vaovao1jp/pico_CW_TRX/Spurious.png

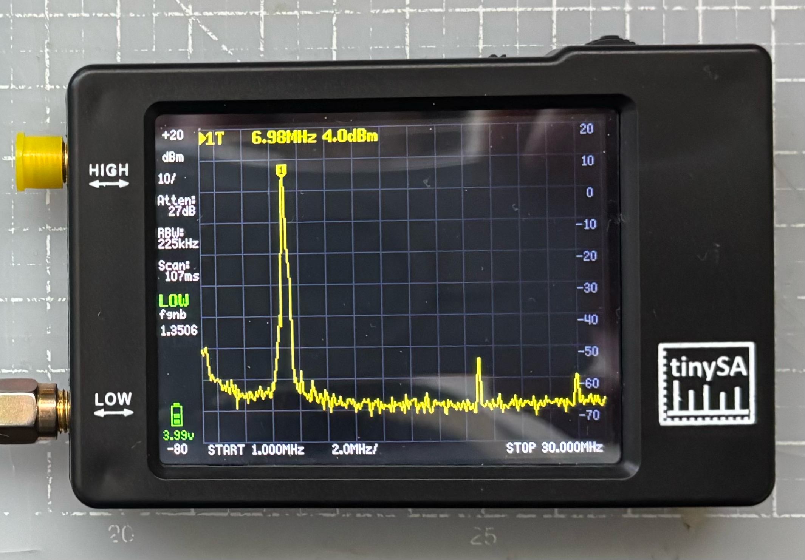
Spurious.png
