vaovao1jp/pico_CW_TRX/Logmag.png

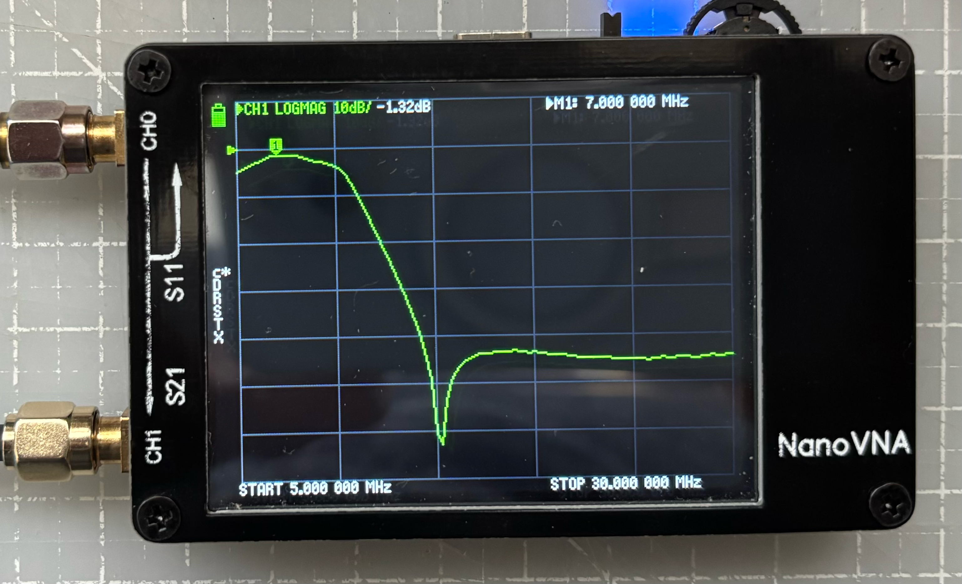
Logmag.png
