vaovao1jp/pico_CW_TRX/2026_4_17_OLED128x64.md

# I changed the OLED to 128x64 and added a waterfall.
I've uploaded a new version of the sketch.
### SDR_pico_CW_RTXv4_0E.ino

### To change the display on the band scope
Line 82 #define SCOPE_SENSITIVITY 15.0f    // Amplitude gain of the scope waveform (the higher the value, the higher the waveform rises)

Line 83 #define SCOPE_OFFSET      3.2f     // Raising the scope's noise floor (to detect invisible micro-noise)

### Waterfall display (signal strength)
Line 140 #define THRESHOLD 1  // Settings for Displaying Signal Strength

The circuit diagram is “pico_40mCW_TRX_microL.pdf”.

JR3XNW 2026/4/17
