vaovao1jp/pico_CW_TRX/pico_CW_TRX_26-07-15.pdf

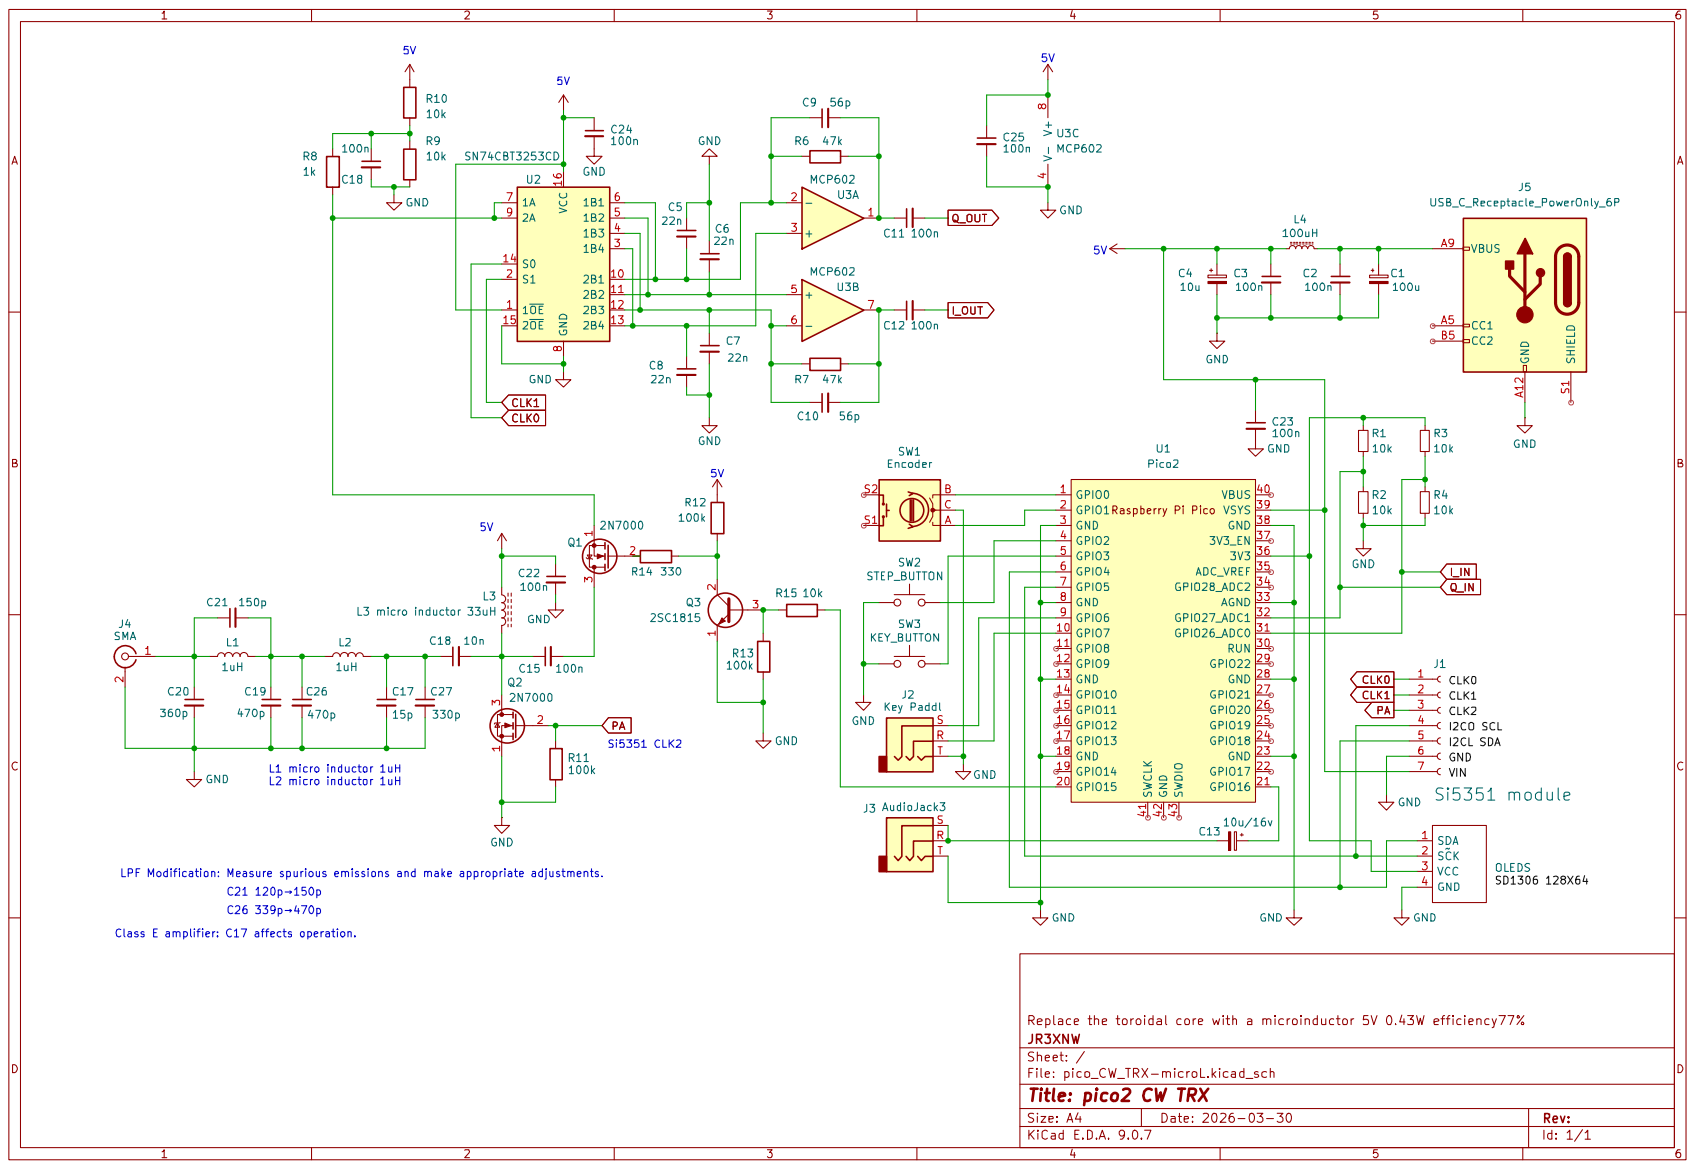
[picture p3: page 1]
