vaovao1jp/pico_CW_TRX/pico_20m_CW_TR.pdf

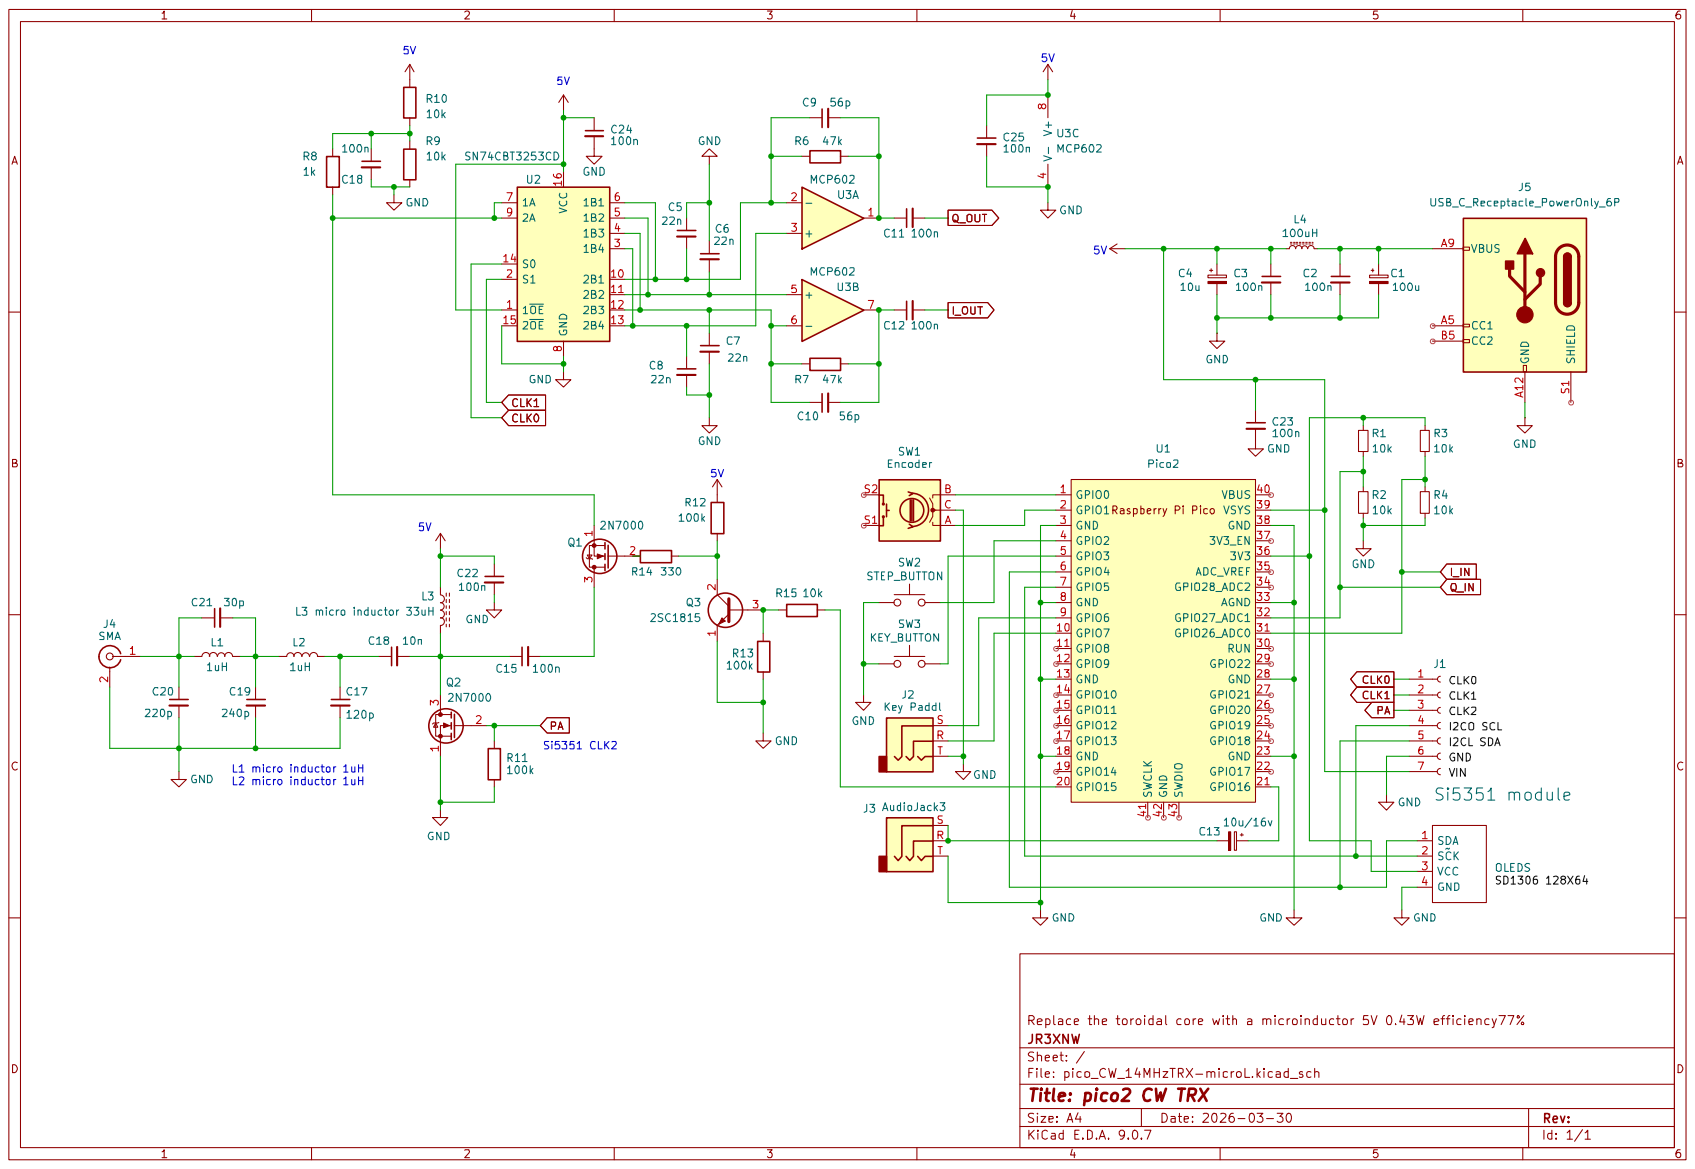
[picture p4: page 1]
