vaovao1jp/pico_CW_TRX/pico_40m_CW_TR.pdf

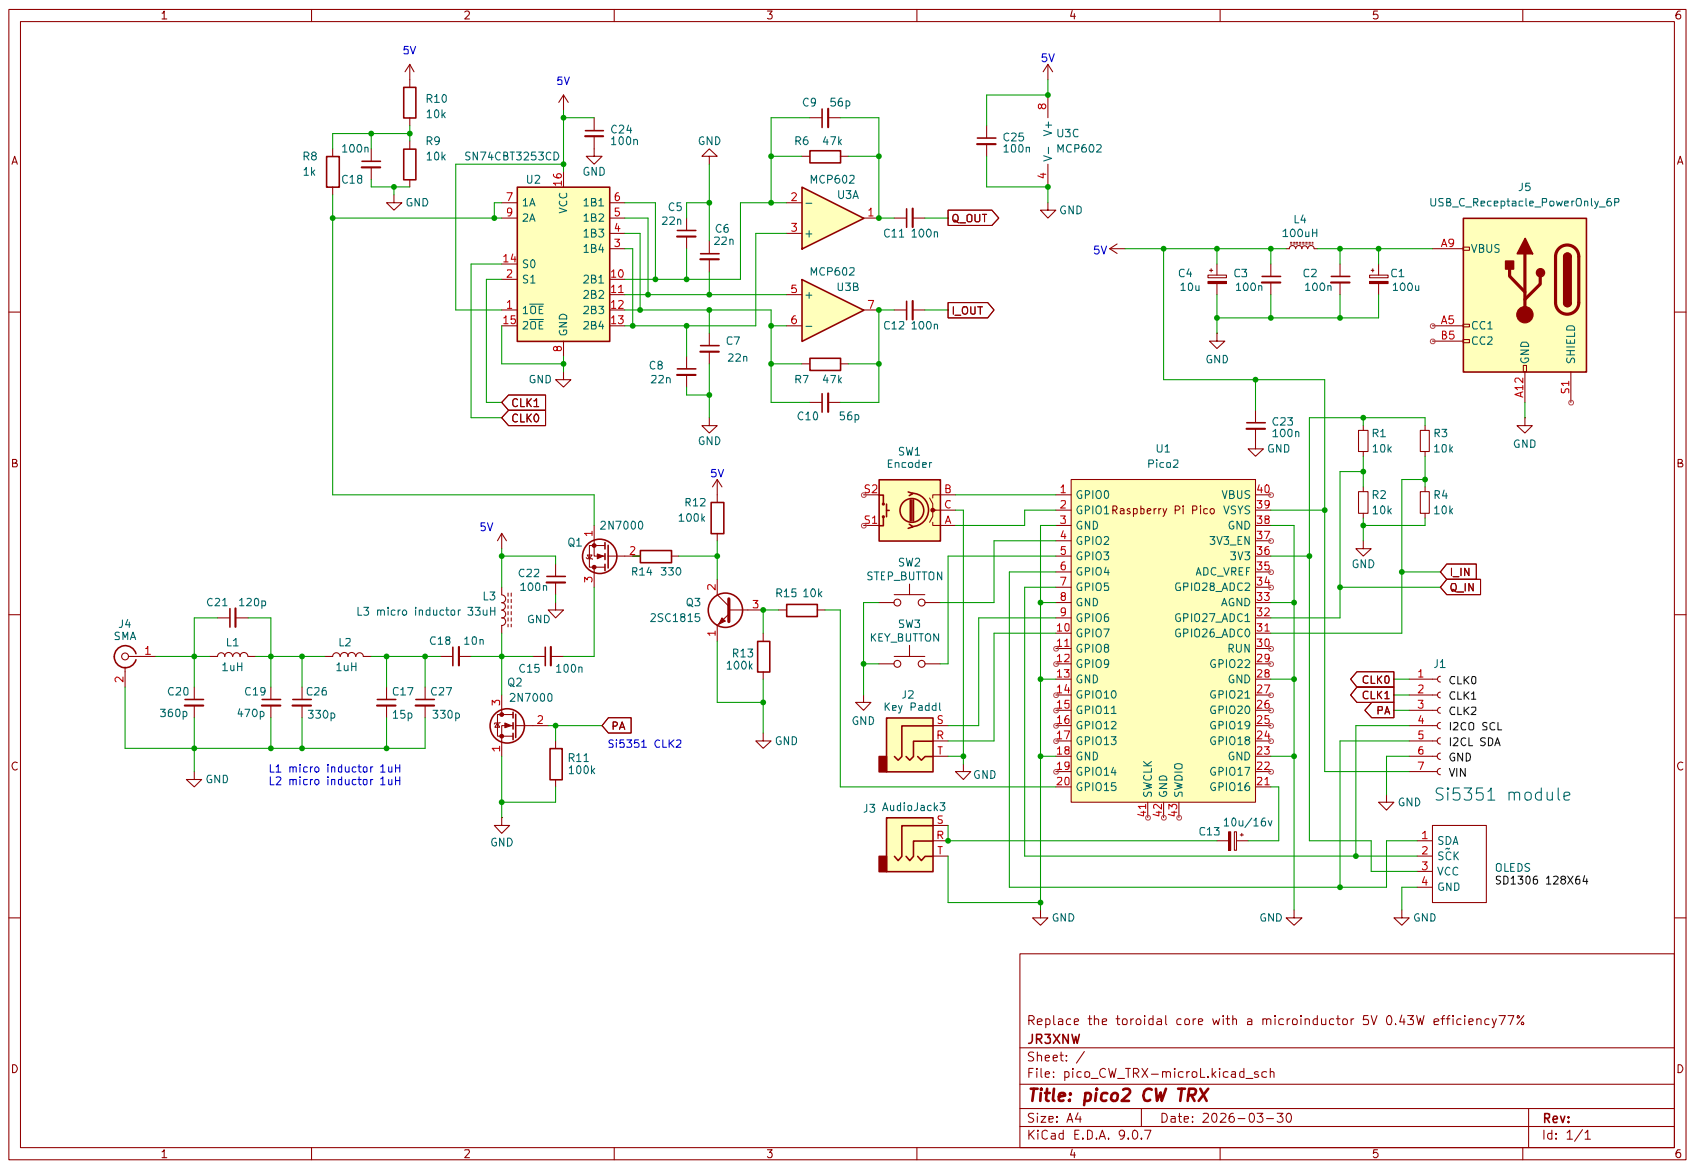
[picture p5: page 1]
