vaovao1jp/pico_CW_TRX/pico_40mCW_TRX_microL.pdf

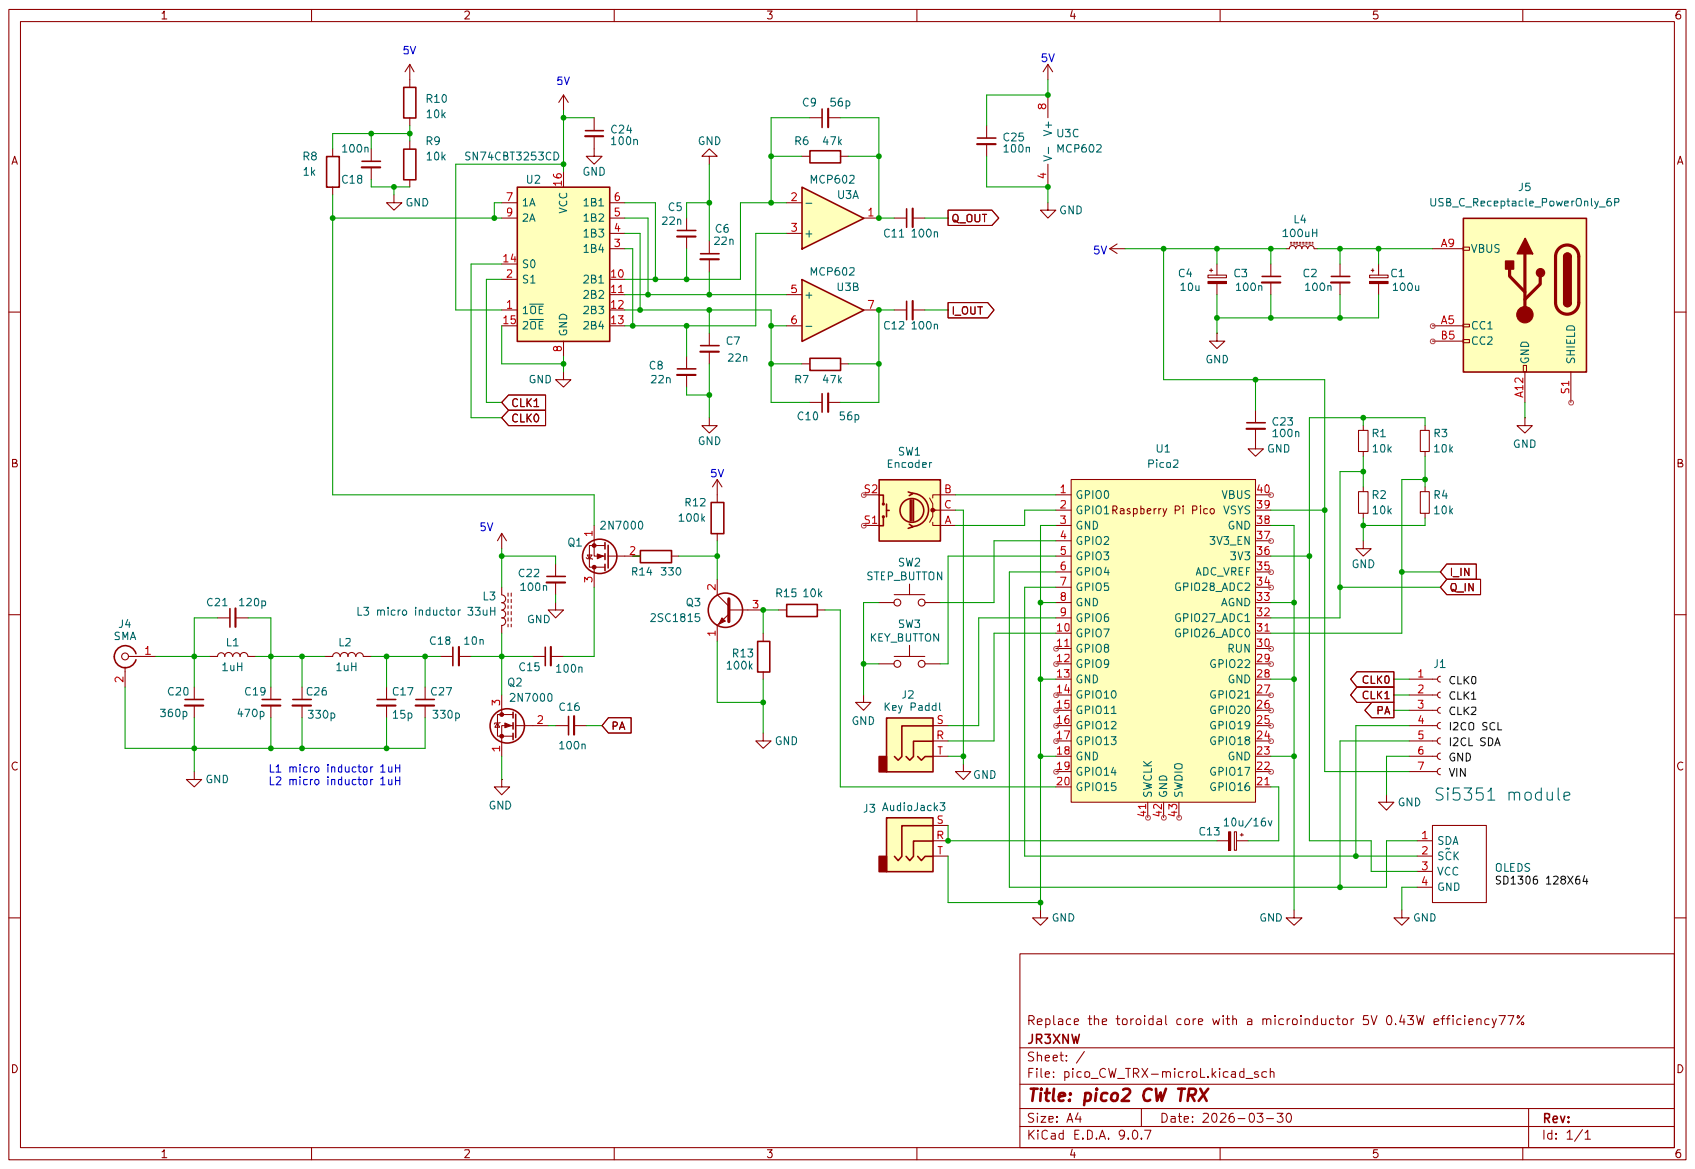
[picture p6: page 1]
