vaovao1jp/pico_CW_TRX/pico_40mCW_TRXClass E_V2.pdf

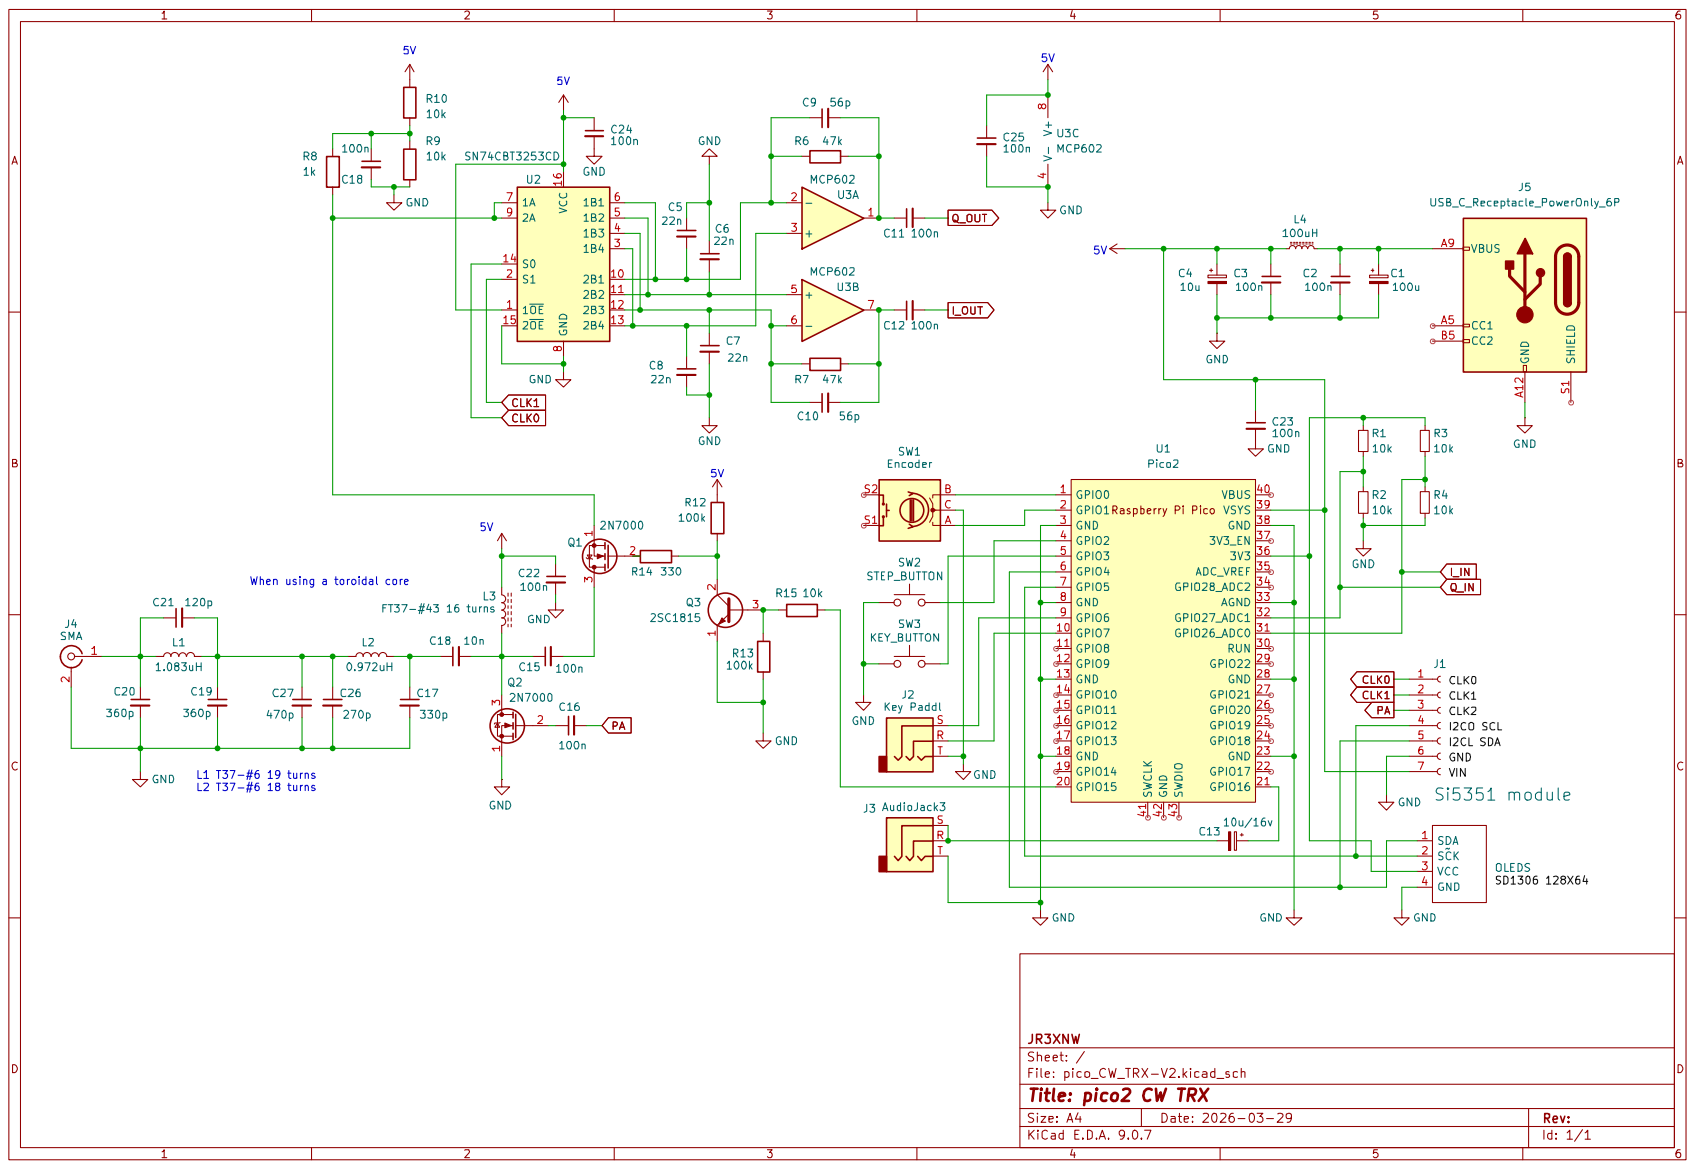
[picture p7: page 1]
