vaovao1jp/pico_CW_TRX/Circuit_Diagram.pdf

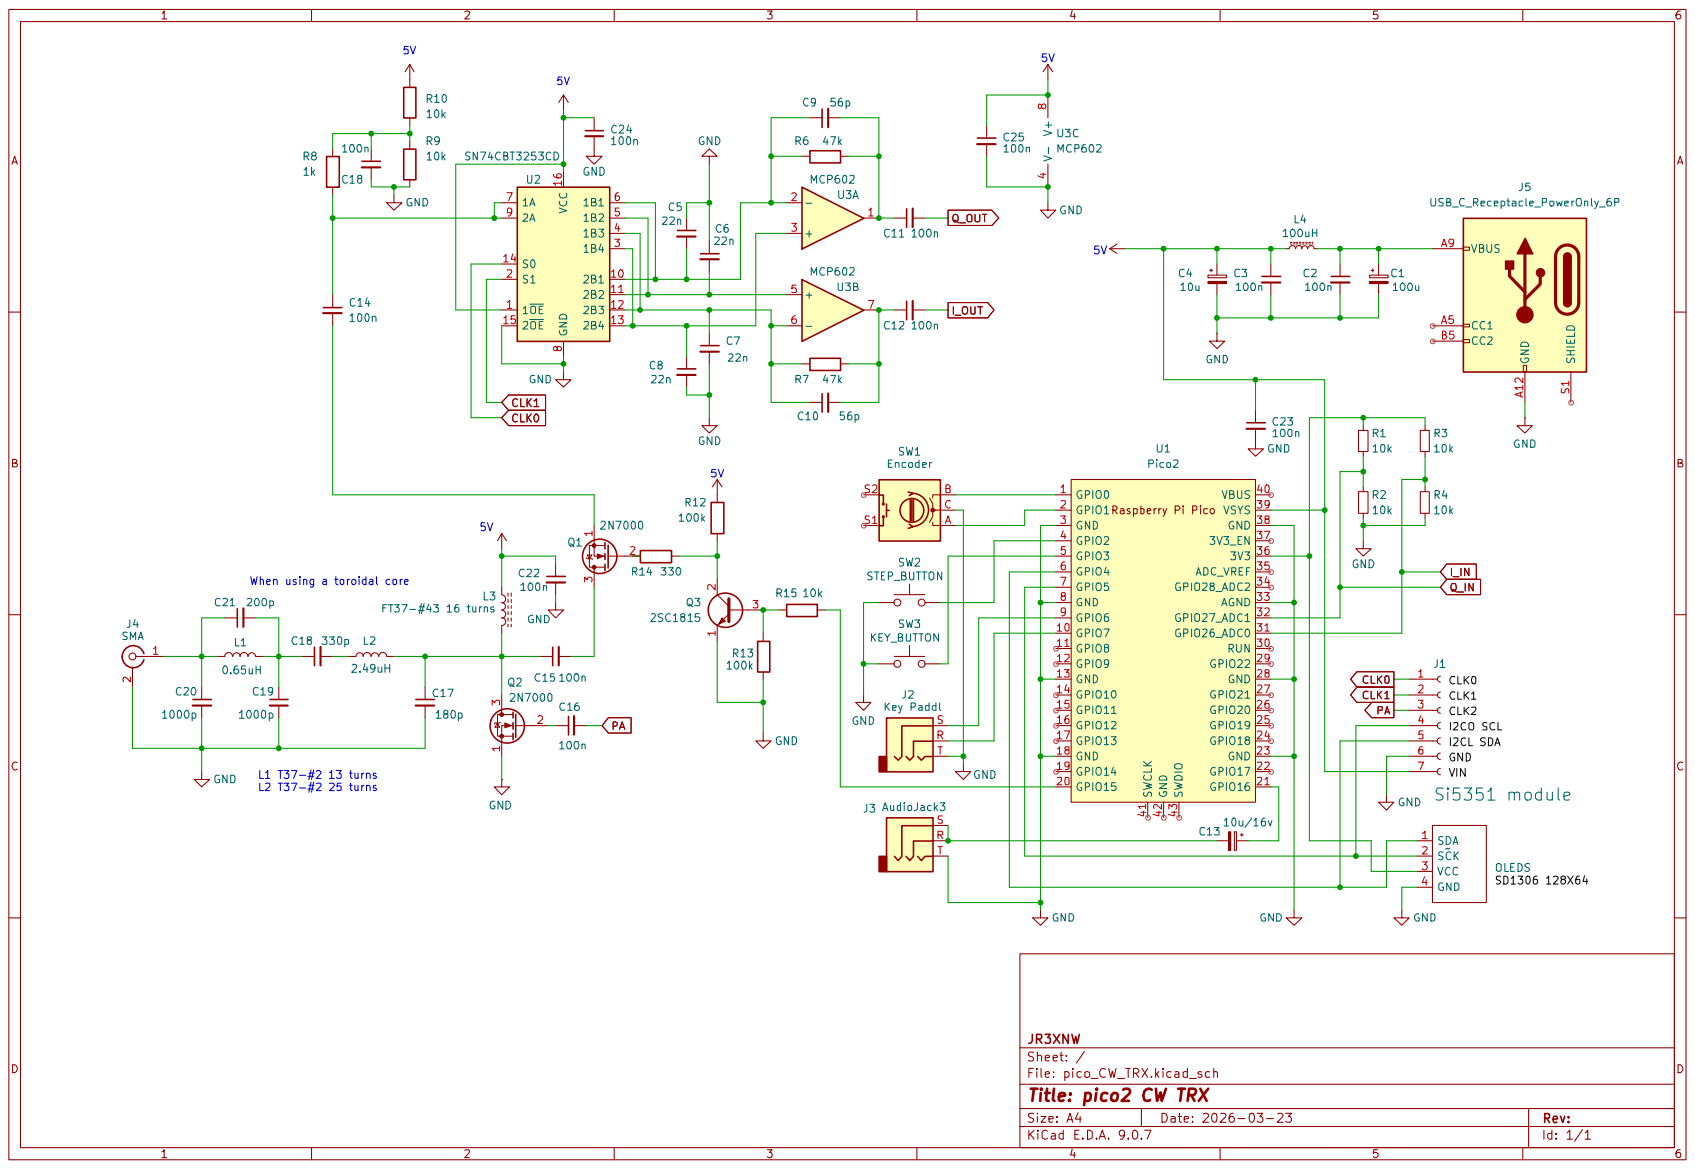
[picture p8: page 1]
